bson/stm32simh/pinmap.png

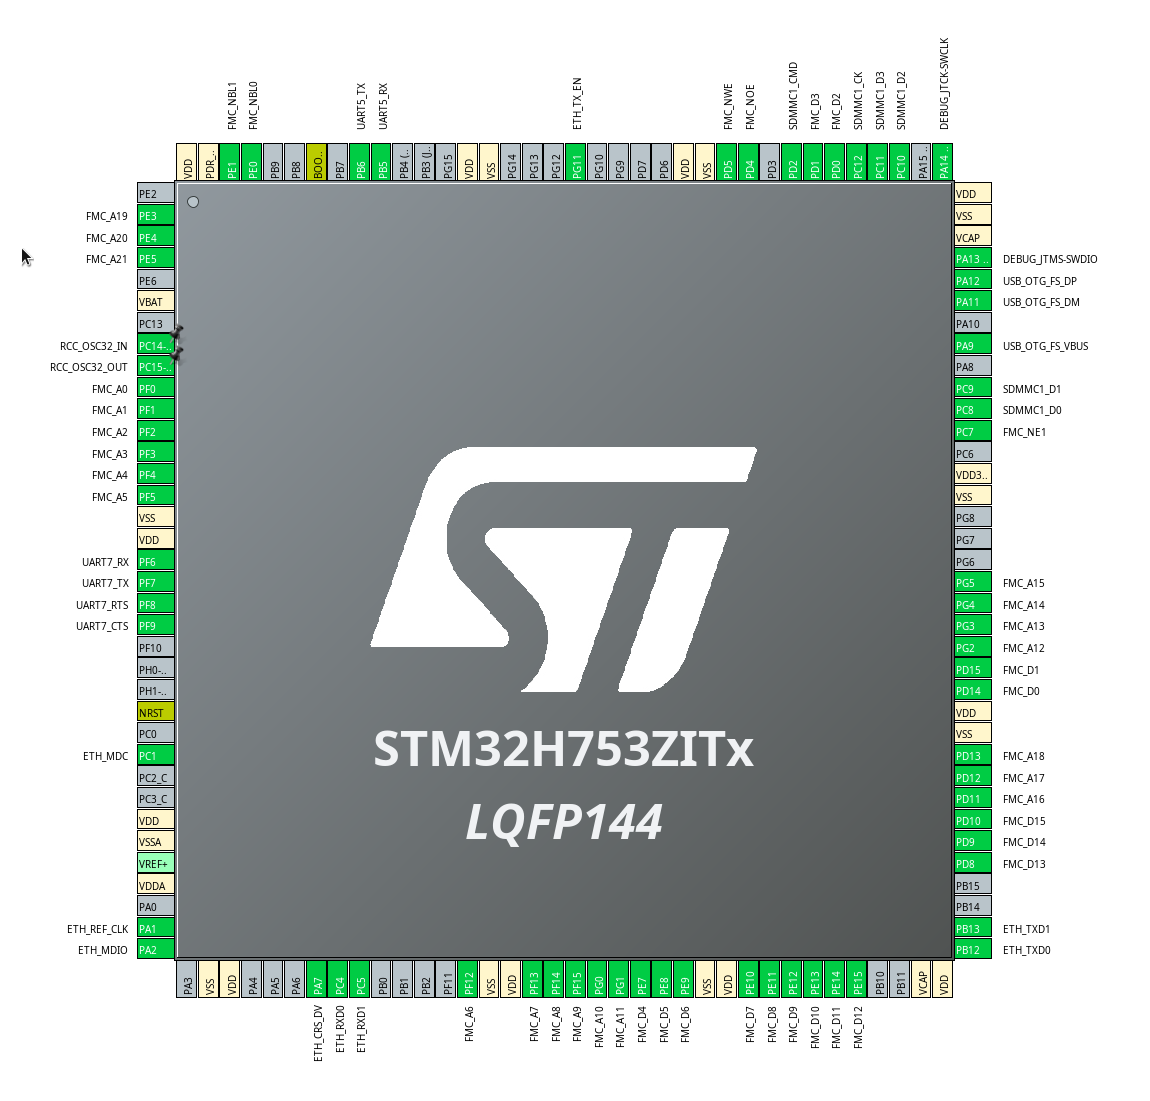
pinmap.png
