bson/stm32simh/stm32simh.kicad_pcb

## KiCad design stm32simh.kicad_pcb (2025-09-15)

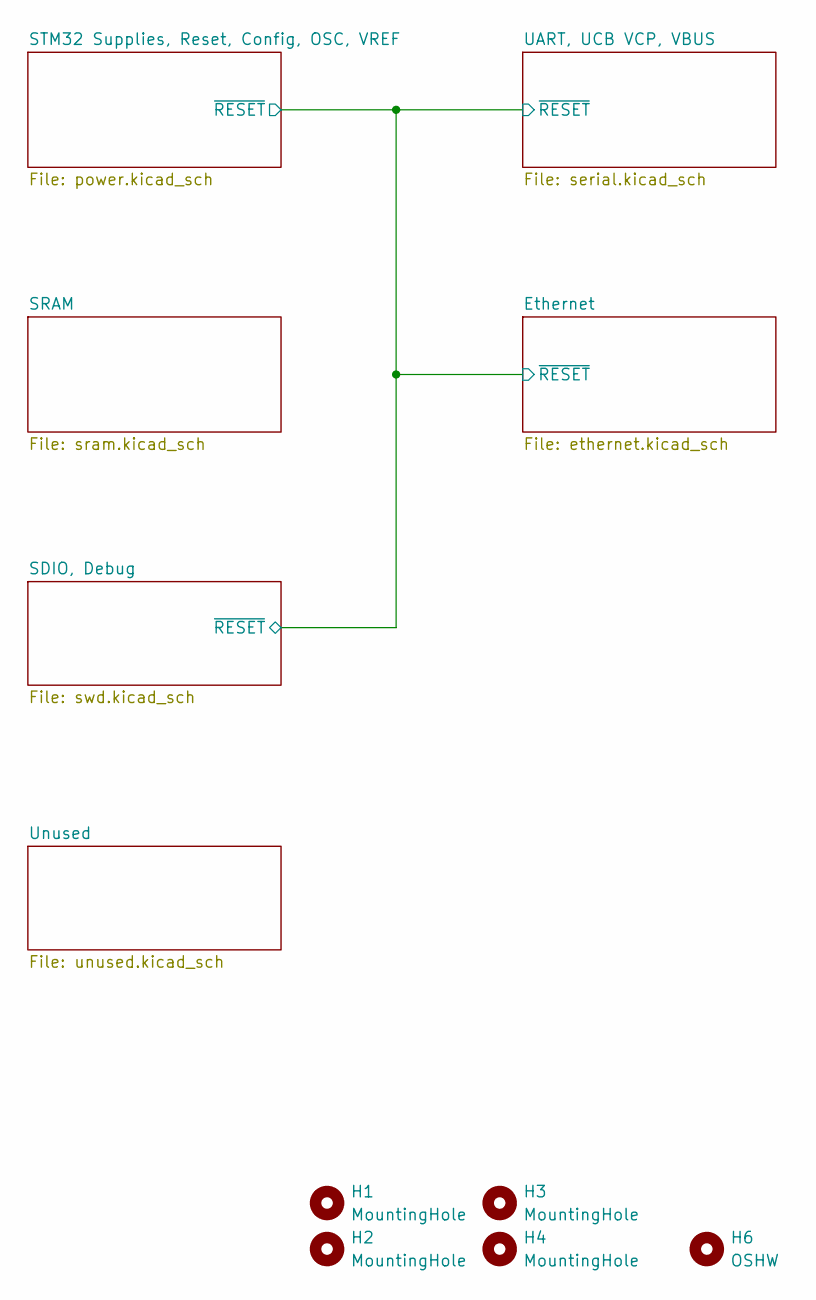
[picture p2: schematic stm32simh.kicad_sch]

Parts:
H1, H2, H3, H4: MountingHole; MountingHole_2.2mm_M2_ISO14580_Pad
H6: OSHW; OSHW-Logo_7.5x8mm_SilkScreen

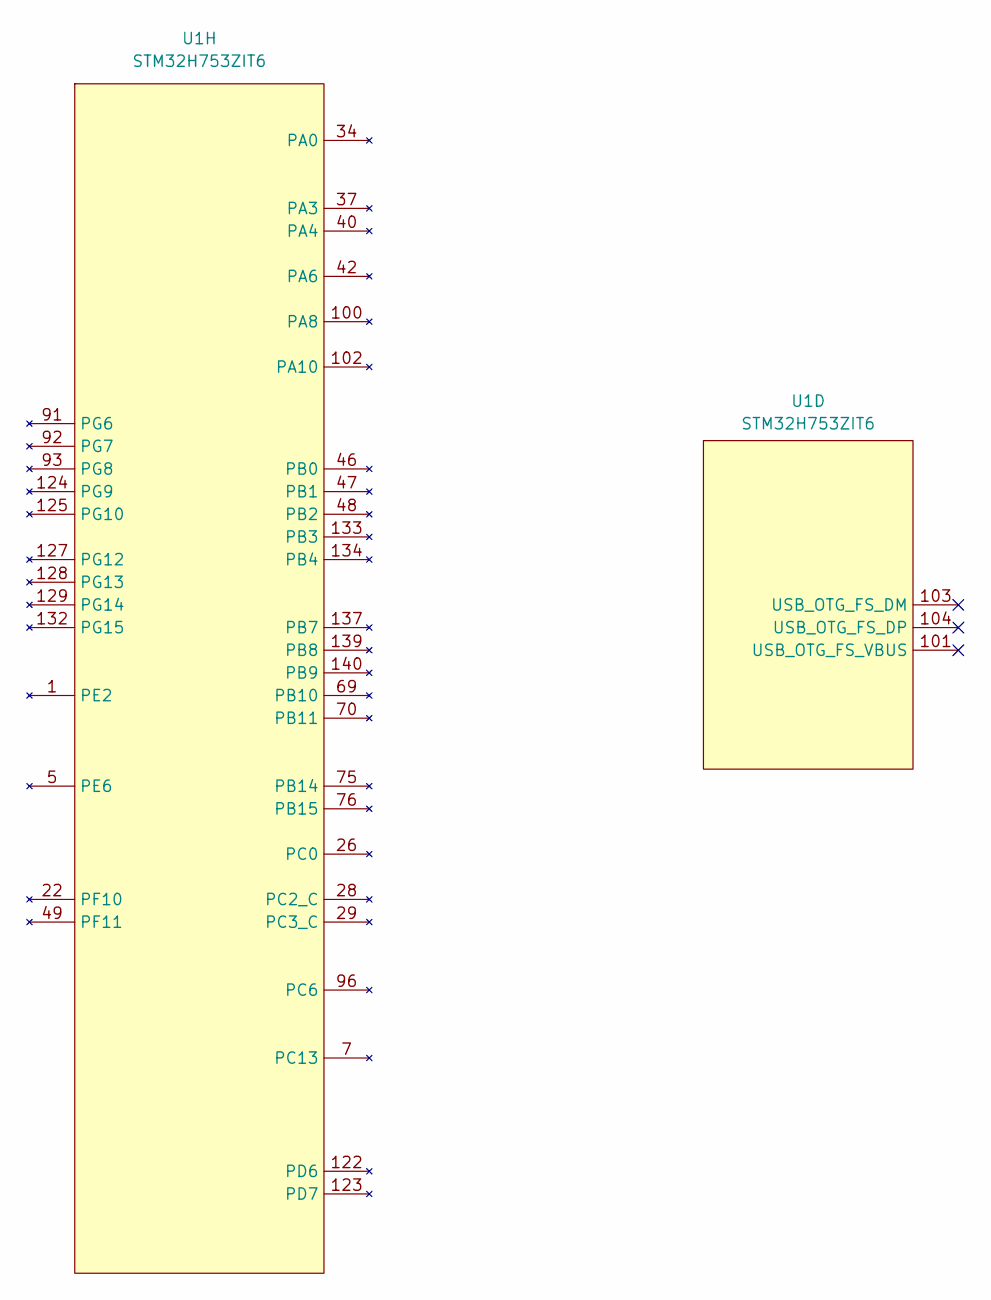
[picture p3: schematic unused.kicad_sch]

Parts:
U1: STM32H753ZIT6; LQFP-144_20x20mm_P0.5mm; MPN STM32H753ZIT6

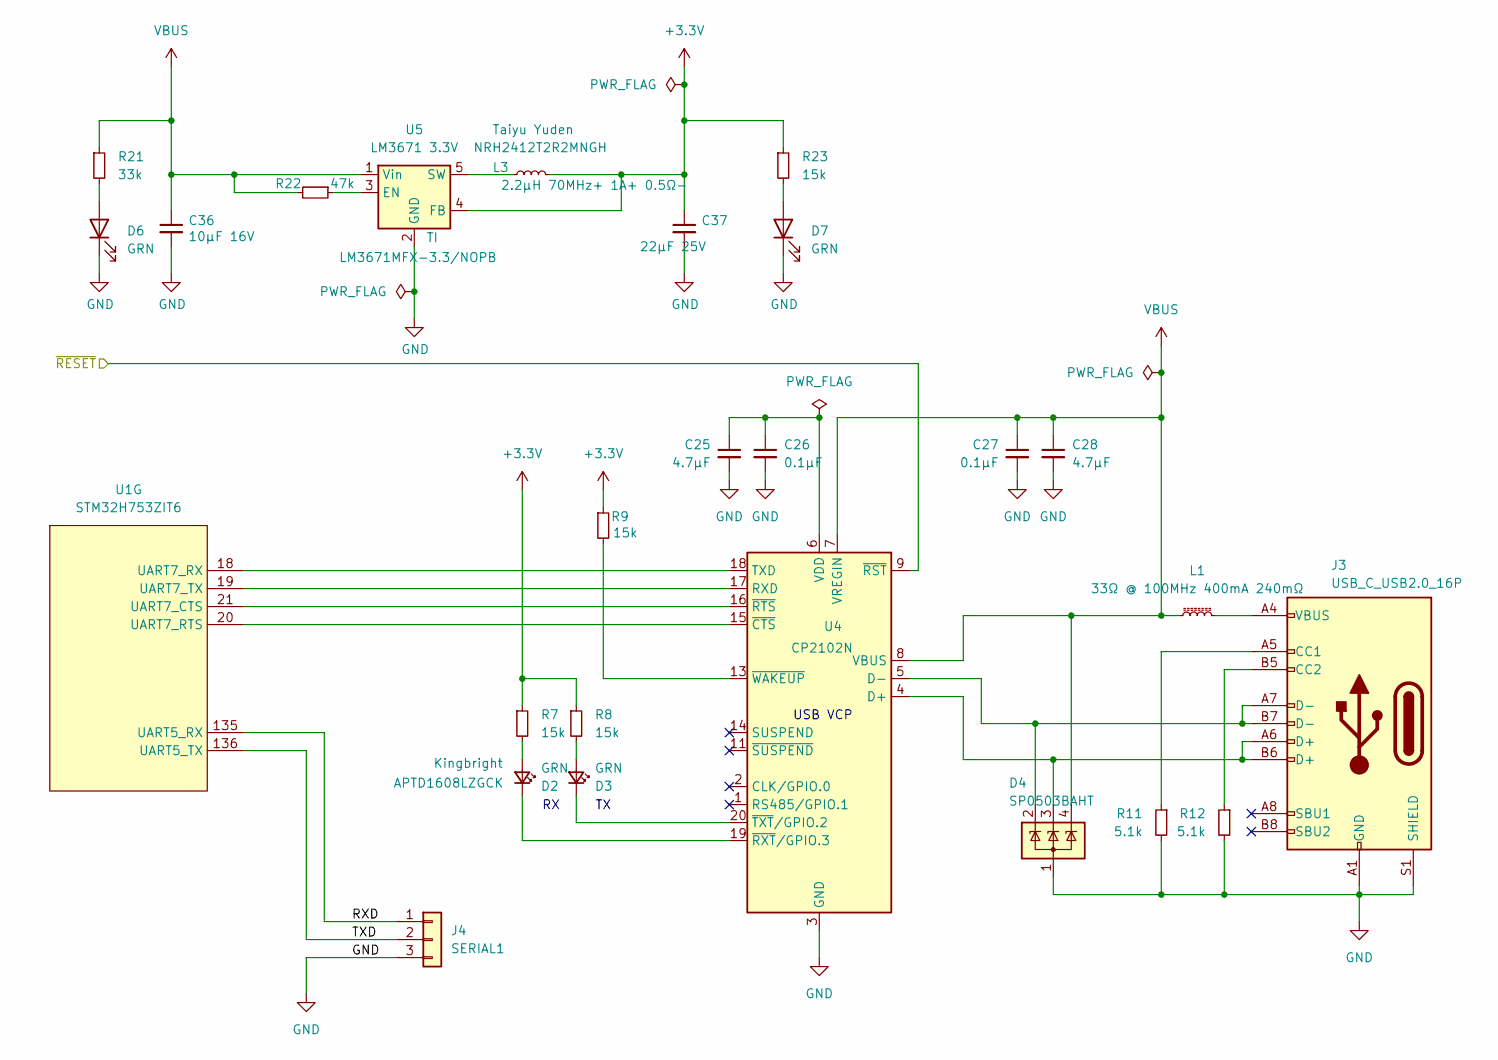
[picture p4: schematic serial.kicad_sch]

Parts:
C25, C28: 4.7µF; C_0805_2012Metric; LCSC C84718
C26, C27: 0.1µF; C_0402_1005Metric; LCSC C3012376
C36: 10µF 16V; C_0603_1608Metric; LCSC C109457
C37: 22µF 25V; C_0805_2012Metric; LCSC C258782
D2, D3: GRN; D_0603_1608Metric; MPN APTD1608LZGCK; LCSC C5246833
D4: SP0503BAHT; SOT-143; LCSC C5337181
D6, D7: GRN; D_0603_1608Metric; LCSC C5246833
J3: USB_C_USB2.0_16P; USB_C_Receptacle_HCTL_HC-TYPE-C-16P-01A; LCSC C2909599
J4: SERIAL1; PinHeader_1x03_P2.54mm_Vertical
L1: 33Ω @ 100MHz 400mA 240mΩ; L_0402_1005Metric; MPN MMZ1005D330CTD25
L3: 2.2µH 70MHz+ 1A+ 0.5Ω-; L_Taiyo-Yuden_NR-24xx; Part NRH2412T2R2MNGH
R7, R8, R23: 15k; R_0402_1005Metric; LCSC C850820
R9: 15k; R_0402_1005Metric; LCSC C375970
R11, R12: 5.1k; R_0402_1005Metric; LCSC C384321
R21: 33k; R_0402_1005Metric; LCSC C2906928
R22: 47k; R_0402_1005Metric; LCSC C3017507
U1: STM32H753ZIT6; LQFP-144_20x20mm_P0.5mm; MPN STM32H753ZIT6
U4: CP2102N; CP2102N-QFN20; LCSC C969913
U5: LM3671 3.3V; TSOT-23-5; Part LM3671MFX-3.3/NOPB; LCSC C201586

Connections:
+3.3V: C37.1, L3.2, R7.1, R8.1, R9.1, R23.1, U5.4 (FB); also elsewhere on the board
/Ethernet/~RESET: U4.9 (~RST); also elsewhere on the board
/UART, UCB VCP, VBUS/RXD: J4.1, U1.135 (UART5_RX)
/UART, UCB VCP, VBUS/TXD: J4.2, U1.136 (UART5_TX)
GND: C25.2, C26.2, C27.2, C28.2, C36.2, C37.2, D4.1 (A), D6.1 (K), D7.1 (K), J3.A1 (GND), J3.A12 (GND), J3.B1 (GND), J3.B12 (GND), J3.S1 (SHIELD), J4.3, R11.2, R12.2, U4.3 (GND), U4.12 (GND), U4.21 (GND), U5.2 (GND); also elsewhere on the board
unnamed: D2.2 (A), R7.2
unnamed: D2.1 (K), U4.19 (~RXT/GPIO.3)
unnamed: D3.2 (A), R8.2
unnamed: D3.1 (K), U4.20 (~TXT/GPIO.2)
unnamed: D6.2 (A), R21.2
unnamed: D7.2 (A), R23.2
unnamed: J3.A5 (CC1), R11.1
unnamed: J3.B5 (CC2), R12.1
unnamed: J3.A4 (VBUS), J3.A9 (VBUS), J3.B4 (VBUS), J3.B9 (VBUS), L1.2
unnamed: U1.21 (UART7_CTS), U4.16 (~RTS)
unnamed: U1.20 (UART7_RTS), U4.15 (~CTS)
unnamed: U1.18 (UART7_RX), U4.18 (TXD)
unnamed: U1.19 (UART7_TX), U4.17 (RXD)
unnamed: D4.3 (K), J3.A6 (D+), J3.B6 (D+), U4.4 (D+)
unnamed: D4.2 (K), J3.A7 (D-), J3.B7 (D-), U4.5 (D-)
unnamed: C25.1, C26.1, U4.6 (VDD)
unnamed: R9.2, U4.13 (~WAKEUP)
unnamed: R22.1, U5.3 (EN)
unnamed: L3.1, U5.5 (SW)
VBUS: C27.1, C28.1, C36.1, D4.4 (K), L1.1, R21.1, R22.2, U4.7 (VREGIN), U4.8 (VBUS), U5.1 (Vin)

Notes on the sheet:
USB VCP

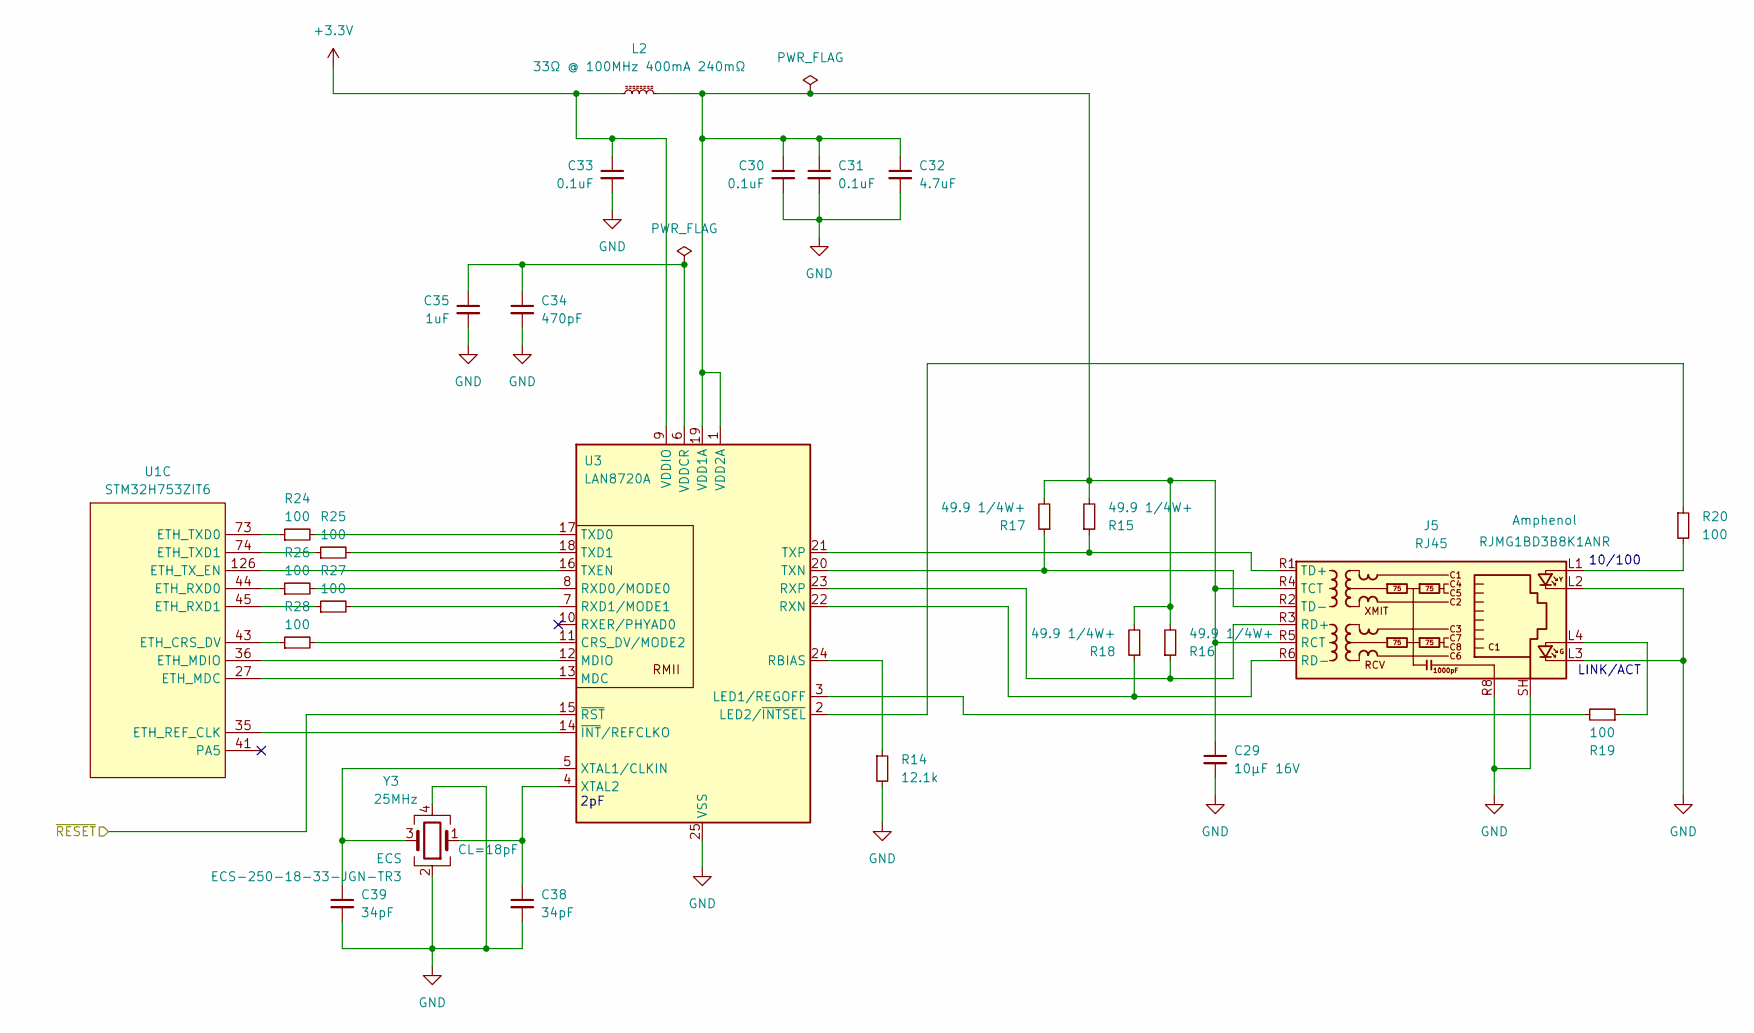
[picture p5: schematic ethernet.kicad_sch]

Parts:
C29: 10µF 16V; C_0603_1608Metric; LCSC C109457
C30, C31, C33: 0.1uF; C_0402_1005Metric
C32: 4.7uF; C_0805_2012Metric
C34: 470pF; C_0402_1005Metric
C35: 1uF; C_0402_1005Metric
C38, C39: 34pF; C_0402_1005Metric
J5: RJ45; RJ45_Amphenol_RJMG1BD3B8K1ANR; Part RJMG1BD3B8K1ANR
L2: 33Ω @ 100MHz 400mA 240mΩ; L_0402_1005Metric; MPN MMZ1005D330CTD25
R14: 12.1k; R_0402_1005Metric
R15, R16, R17, R18: 49.9 1/4W+; R_0805_2012Metric; LCSC C4088942
R19, R20, R24, R25, R26, R27, R28: 100; R_0402_1005Metric; LCSC C453594
U1: STM32H753ZIT6; LQFP-144_20x20mm_P0.5mm; MPN STM32H753ZIT6
U3: LAN8720A; VQFN-24-1EP_4x4mm_P0.5mm_EP2.5x2.5mm
Y3: 25MHz; Crystal_SMD_3225-4Pin_3.2x2.5mm; Part ECS-250-18-33-JGN-TR3; LCSC C7294571

Connections:
+3.3V: C33.1, L2.1, U3.9 (VDDIO); also elsewhere on the board
/Ethernet/~RESET: U3.15 (~RST); also elsewhere on the board
GND: C29.2, C30.2, C31.2, C32.2, C33.2, C34.2, C35.2, C38.2, C39.2, J5.L2, J5.L3, J5.R8, J5.SH, R14.2, U3.25 (VSS), Y3.2, Y3.4; also elsewhere on the board
unnamed: J5.L1, R20.2
unnamed: J5.L4, R19.1
unnamed: C29.1, C30.1, C31.1, C32.1, J5.R4 (TCT), J5.R5 (RCT), L2.2, R15.2, R16.2, R17.2, R18.2, U3.1 (VDD2A), U3.19 (VDD1A)
unnamed: J5.R3 (RD+), R16.1, U3.23 (RXP)
unnamed: J5.R6 (RD-), R18.1, U3.22 (RXN)
unnamed: J5.R1 (TD+), R15.1, U3.21 (TXP)
unnamed: J5.R2 (TD-), R17.1, U3.20 (TXN)
unnamed: R28.1, U1.43 (ETH_CRS_DV)
unnamed: U1.27 (ETH_MDC), U3.13 (MDC)
unnamed: U1.36 (ETH_MDIO), U3.12 (MDIO)
unnamed: U1.35 (ETH_REF_CLK), U3.14 (~INT/REFCLKO)
unnamed: R26.1, U1.44 (ETH_RXD0)
unnamed: R27.1, U1.45 (ETH_RXD1)
unnamed: R24.1, U1.73 (ETH_TXD0)
unnamed: R25.1, U1.74 (ETH_TXD1)
unnamed: U1.126 (ETH_TX_EN), U3.16 (TXEN)
unnamed: R28.2, U3.11 (CRS_DV/MODE2)
unnamed: R19.2, U3.3 (LED1/REGOFF)
unnamed: R20.1, U3.2 (LED2/~INTSEL)
unnamed: R14.1, U3.24 (RBIAS)
unnamed: R26.2, U3.8 (RXD0/MODE0)
unnamed: R27.2, U3.7 (RXD1/MODE1)
unnamed: R24.2, U3.17 (TXD0)
unnamed: R25.2, U3.18 (TXD1)
unnamed: C34.1, C35.1, U3.6 (VDDCR)
unnamed: C39.1, U3.5 (XTAL1/CLKIN), Y3.3
unnamed: C38.1, U3.4 (XTAL2), Y3.1

Notes on the sheet:
LINK/ACT
2pF
10/100

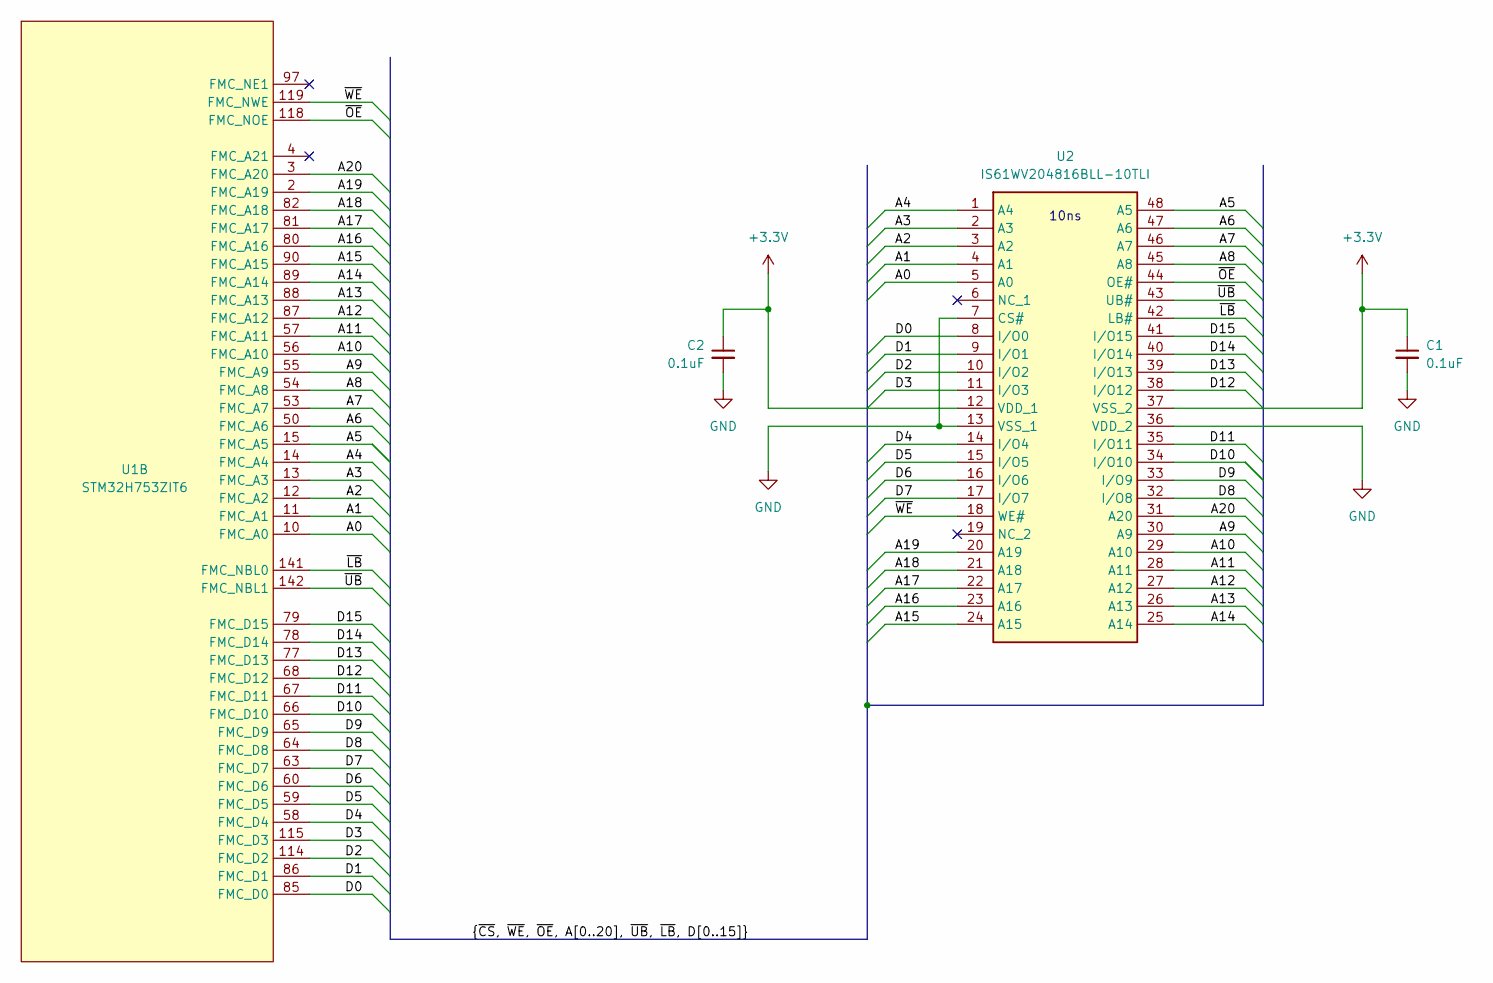
[picture p6: schematic sram.kicad_sch]

Parts:
C1, C2: 0.1uF; C_0402_1005Metric
U1: STM32H753ZIT6; LQFP-144_20x20mm_P0.5mm; MPN STM32H753ZIT6
U2: IS61WV204816BLL-10TLI; SOP50P2000X120-48N; Mouser Part Number 870-WV204816BLL10TLI

Connections:
+3.3V: C1.1, C2.1, U2.12 (VDD_1), U2.37 (VSS_2); also elsewhere on the board
/SRAM/A0: U1.10 (FMC_A0), U2.5 (A0)
/SRAM/A1: U1.11 (FMC_A1), U2.4 (A1)
/SRAM/A2: U1.12 (FMC_A2), U2.3 (A2)
/SRAM/A3: U1.13 (FMC_A3), U2.2 (A3)
/SRAM/A4: U1.14 (FMC_A4), U2.1 (A4)
/SRAM/A5: U1.15 (FMC_A5), U2.48 (A5)
/SRAM/A6: U1.50 (FMC_A6), U2.47 (A6)
/SRAM/A7: U1.53 (FMC_A7), U2.46 (A7)
/SRAM/A8: U1.54 (FMC_A8), U2.45 (A8)
/SRAM/A9: U1.55 (FMC_A9), U2.30 (A9)
/SRAM/A10: U1.56 (FMC_A10), U2.29 (A10)
/SRAM/A11: U1.57 (FMC_A11), U2.28 (A11)
/SRAM/A12: U1.87 (FMC_A12), U2.27 (A12)
/SRAM/A13: U1.88 (FMC_A13), U2.26 (A13)
/SRAM/A14: U1.89 (FMC_A14), U2.25 (A14)
/SRAM/A15: U1.90 (FMC_A15), U2.24 (A15)
/SRAM/A16: U1.80 (FMC_A16), U2.23 (A16)
/SRAM/A17: U1.81 (FMC_A17), U2.22 (A17)
/SRAM/A18: U1.82 (FMC_A18), U2.21 (A18)
/SRAM/A19: U1.2 (FMC_A19), U2.20 (A19)
/SRAM/A20: U1.3 (FMC_A20), U2.31 (A20)
/SRAM/D0: U1.85 (FMC_D0), U2.8 (I/O0)
/SRAM/D1: U1.86 (FMC_D1), U2.9 (I/O1)
/SRAM/D2: U1.114 (FMC_D2), U2.10 (I/O2)
/SRAM/D3: U1.115 (FMC_D3), U2.11 (I/O3)
/SRAM/D4: U1.58 (FMC_D4), U2.14 (I/O4)
/SRAM/D5: U1.59 (FMC_D5), U2.15 (I/O5)
/SRAM/D6: U1.60 (FMC_D6), U2.16 (I/O6)
/SRAM/D7: U1.63 (FMC_D7), U2.17 (I/O7)
/SRAM/D8: U1.64 (FMC_D8), U2.32 (I/O8)
/SRAM/D9: U1.65 (FMC_D9), U2.33 (I/O9)
/SRAM/D10: U1.66 (FMC_D10), U2.34 (I/O10)
/SRAM/D11: U1.67 (FMC_D11), U2.35 (I/O11)
/SRAM/D12: U1.68 (FMC_D12), U2.38 (I/O12)
/SRAM/D13: U1.77 (FMC_D13), U2.39 (I/O13)
/SRAM/D14: U1.78 (FMC_D14), U2.40 (I/O14)
/SRAM/D15: U1.79 (FMC_D15), U2.41 (I/O15)
/SRAM/~LB: U1.141 (FMC_NBL0), U2.42 (LB#)
/SRAM/~OE: U1.118 (FMC_NOE), U2.44 (OE#)
/SRAM/~UB: U1.142 (FMC_NBL1), U2.43 (UB#)
/SRAM/~WE: U1.119 (FMC_NWE), U2.18 (WE#)
GND: C1.2, C2.2, U2.7 (CS#), U2.13 (VSS_1), U2.36 (VDD_2); also elsewhere on the board

Notes on the sheet:
10ns

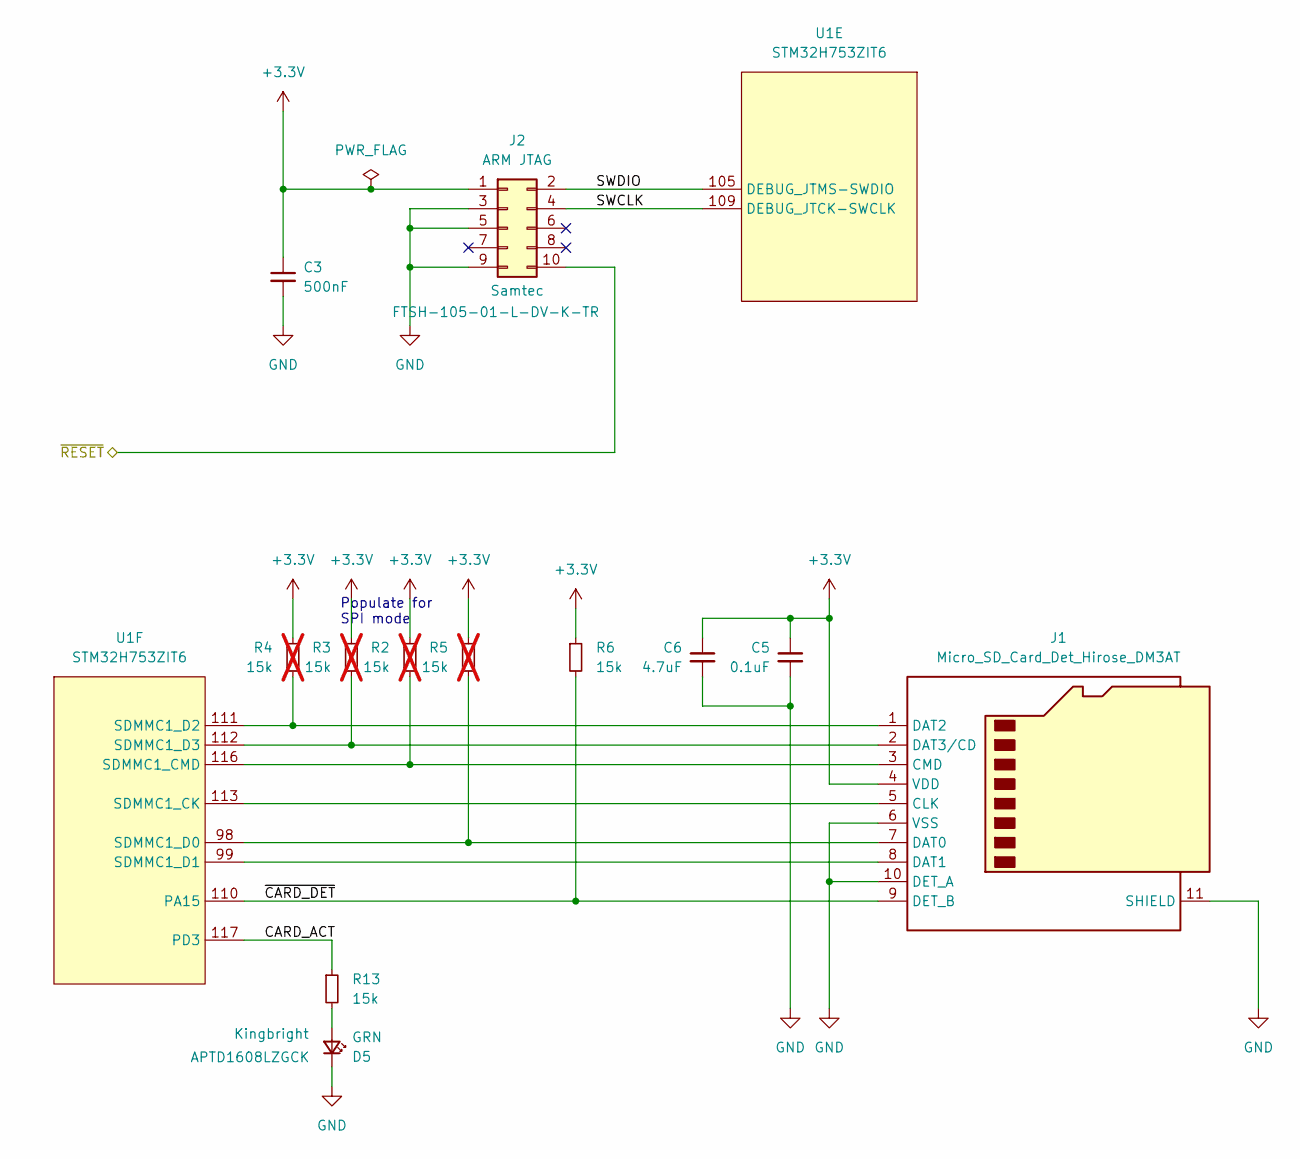
[picture p7: schematic swd.kicad_sch]

Parts:
C3: 500nF; C_0402_1005Metric
C5: 0.1uF; C_0402_1005Metric
C6: 4.7uF; C_0805_2012Metric
D5: GRN; D_0603_1608Metric; MPN APTD1608LZGCK; LCSC C5246833
J1: Micro_SD_Card_Det_Hirose_DM3AT; microSD_HC_Hirose_DM3AT-SF-PEJM5
J2: ARM JTAG; SOIC-10_3.9x4.9mm_P1mm; MPN FTSH-105-01-L-DV-K-TR
R2, R3, R4, R5: 15k; R_0402_1005Metric; not fitted
R6: 15k; R_0402_1005Metric
R13: 15k; R_0402_1005Metric; LCSC C850820
U1: STM32H753ZIT6; LQFP-144_20x20mm_P0.5mm; MPN STM32H753ZIT6

Connections:
+3.3V: C3.1, C5.1, C6.1, J1.4 (VDD), J2.1, R2.1, R3.1, R4.1, R5.1, R6.1; also elsewhere on the board
/Ethernet/~RESET: J2.10; also elsewhere on the board
/SDIO, Debug/CARD_ACT: R13.1, U1.117 (PD3)
/SDIO, Debug/SWCLK: J2.4, U1.109 (DEBUG_JTCK-SWCLK)
/SDIO, Debug/SWDIO: J2.2, U1.105 (DEBUG_JTMS-SWDIO)
/SDIO, Debug/~CARD_DET: J1.9 (DET_B), R6.2, U1.110 (PA15)
GND: C3.2, C5.2, C6.2, D5.1 (K), J1.6 (VSS), J1.10 (DET_A), J1.11 (SHIELD), J2.3, J2.5, J2.9; also elsewhere on the board
unnamed: D5.2 (A), R13.2
unnamed: J1.5 (CLK), U1.113 (SDMMC1_CK)
unnamed: J1.3 (CMD), R2.2, U1.116 (SDMMC1_CMD)
unnamed: J1.7 (DAT0), R5.2, U1.98 (SDMMC1_D0)
unnamed: J1.8 (DAT1), U1.99 (SDMMC1_D1)
unnamed: J1.1 (DAT2), R4.2, U1.111 (SDMMC1_D2)
unnamed: J1.2 (DAT3/CD), R3.2, U1.112 (SDMMC1_D3)

Notes on the sheet:
Populate for SPI mode

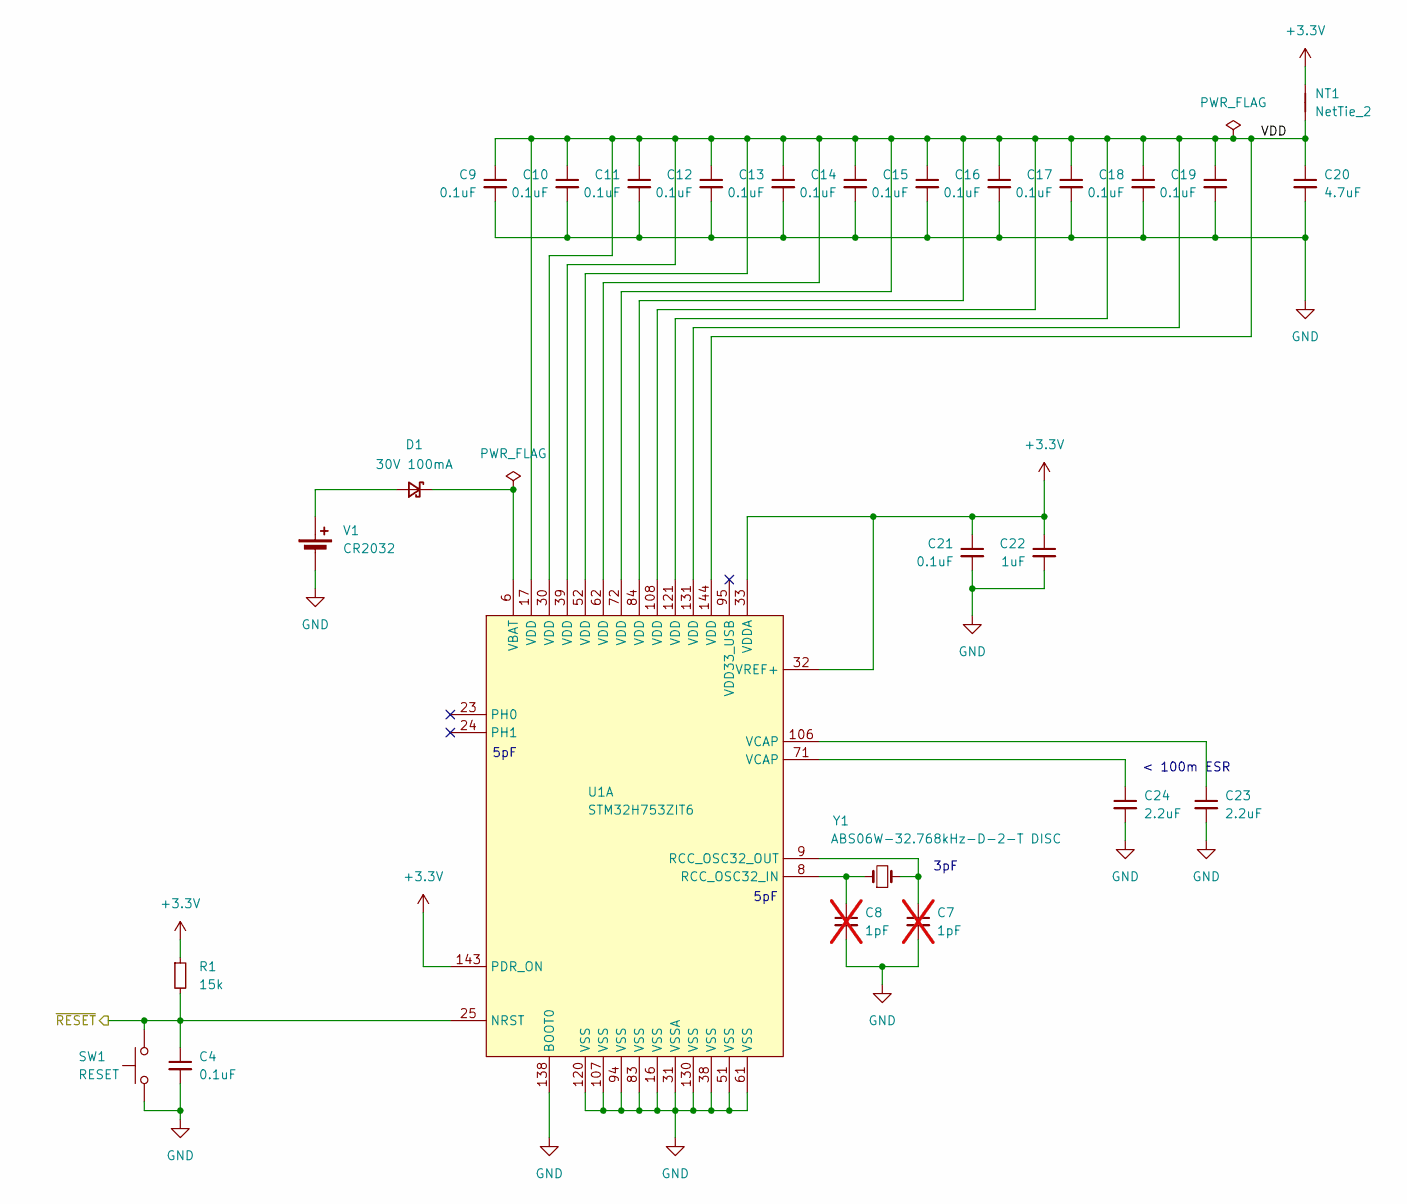
[picture p8: schematic power.kicad_sch]

Parts:
C4, C9, C10, C11, C12, C13, C14, C15, C16, C17, C18, C19, C21: 0.1uF; C_0402_1005Metric
C7, C8: 1pF; C_0402_1005Metric; not fitted
C20: 4.7uF; C_0805_2012Metric
C22: 1uF; C_0402_1005Metric
C23, C24: 2.2uF; C_0603_1608Metric
D1: 30V 100mA; D_0603_1608Metric; MPN CDBU0130L-HF
NT1: NetTie_2; NetTie-2_SMD_Pad0.5mm
R1: 15k; R_0402_1005Metric
SW1: RESET; SW_SPST_CK_RS282G05A3
U1: STM32H753ZIT6; LQFP-144_20x20mm_P0.5mm; MPN STM32H753ZIT6
V1: CR2032; BatteryHolder_Keystone_1060_1x2032; MPN 1060TR
Y1: ABS06W-32.768kHz-D-2-T DISC; Crystal_SMD_2012-2Pin_2.0x1.2mm; MPN ABS06W-32.768KHZ-D-2-T

Connections:
+3.3V: C21.1, C22.1, NT1.2, R1.1, U1.32 (VREF+), U1.33 (VDDA), U1.143 (PDR_ON); also elsewhere on the board
/Ethernet/~RESET: C4.1, R1.2, SW1.1, U1.25 (NRST); also elsewhere on the board
/STM32 Supplies, Reset, Config, OSC, VREF/VDD: C9.1, C10.1, C11.1, C12.1, C13.1, C14.1, C15.1, C16.1, C17.1, C18.1, C19.1, C20.1, NT1.1, U1.17 (VDD), U1.30 (VDD), U1.39 (VDD), U1.52 (VDD), U1.62 (VDD), U1.72 (VDD), U1.84 (VDD), U1.108 (VDD), U1.121 (VDD), U1.131 (VDD), U1.144 (VDD)
GND: C4.2, C7.2, C8.2, C9.2, C10.2, C11.2, C12.2, C13.2, C14.2, C15.2, C16.2, C17.2, C18.2, C19.2, C20.2, C21.2, C22.2, C23.2, C24.2, SW1.2, U1.16 (VSS), U1.31 (VSSA), U1.38 (VSS), U1.51 (VSS), U1.61 (VSS), U1.83 (VSS), U1.94 (VSS), U1.107 (VSS), U1.120 (VSS), U1.130 (VSS), U1.138 (BOOT0), V1.2 (-); also elsewhere on the board
unnamed: C23.1, U1.106 (VCAP)
unnamed: C24.1, U1.71 (VCAP)
unnamed: D1.2 (A), V1.1 (+)
unnamed: D1.1 (K), U1.6 (VBAT)
unnamed: C8.1, U1.8 (RCC_OSC32_IN), Y1.1
unnamed: C7.1, U1.9 (RCC_OSC32_OUT), Y1.2

Notes on the sheet:
5pF
3pF
< 100m ESR

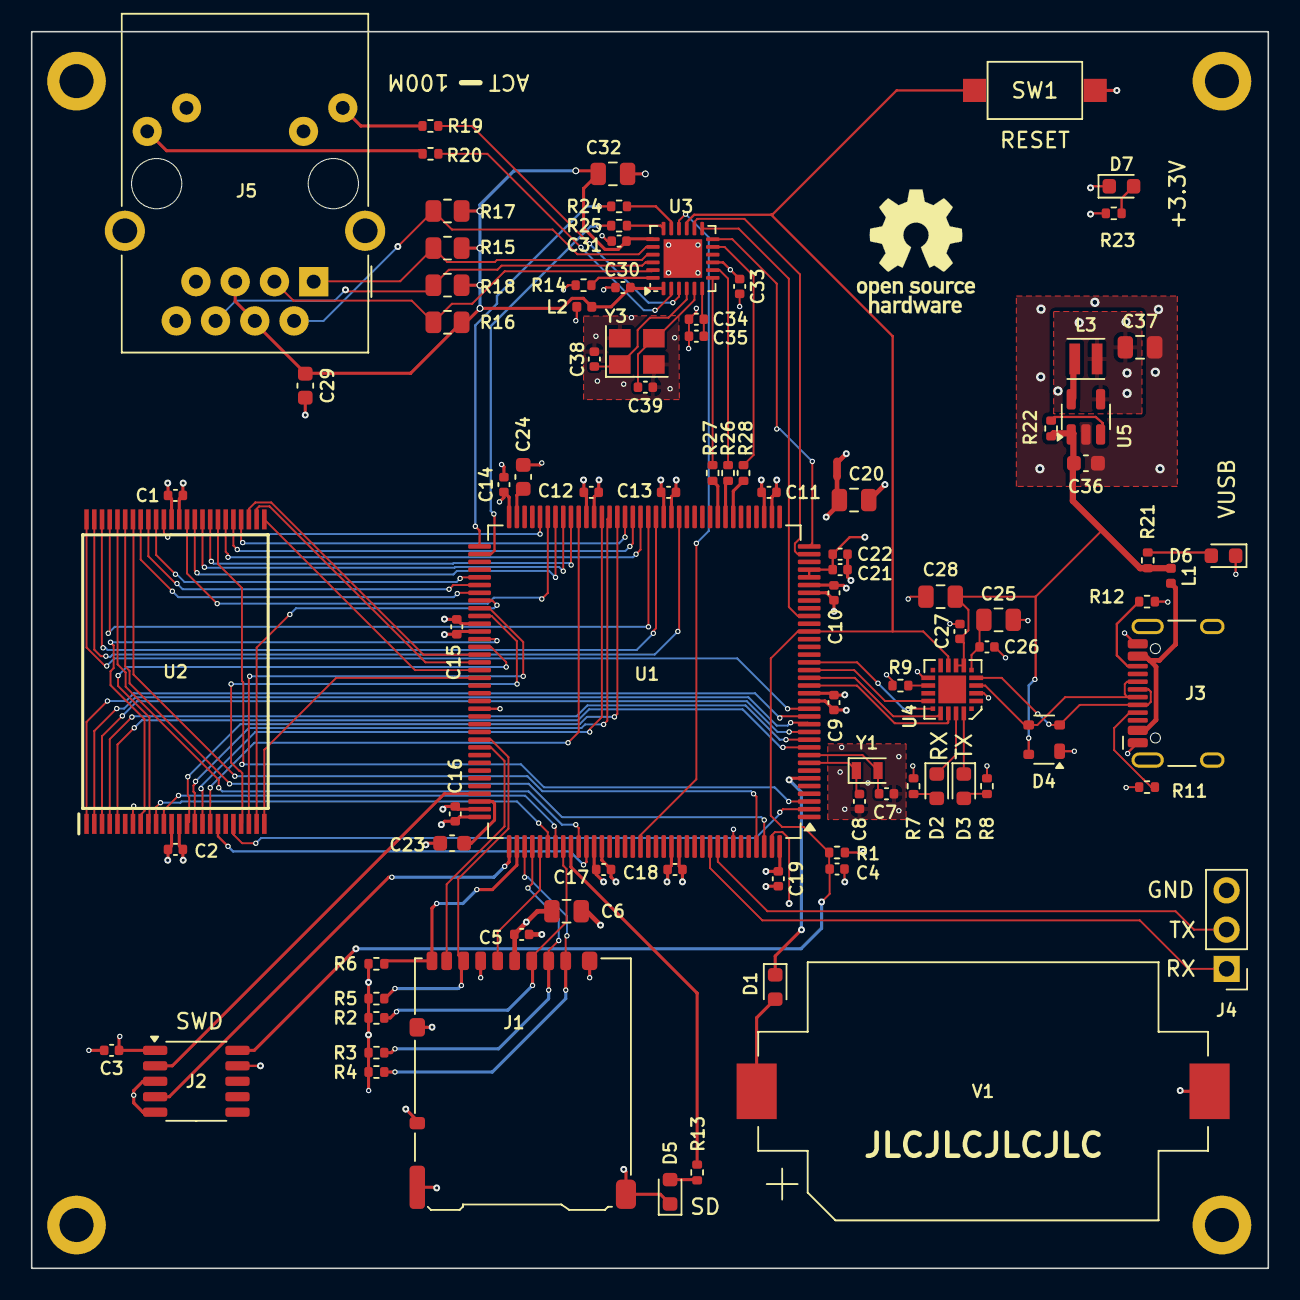
[picture p9: board stm32simh.kicad_pcb from above]

Board: 4 copper layers, 80.0 x 80.0 mm, 96 parts (0 on the bottom side), 111 nets.
