bson/stm32simh/(commit log)

2024-10-08 add a bunch of files
    [power.kicad_sch, sram.kicad_sch, stm32simh.kicad_pcb, stm32simh.kicad_sch, swd.kicad_sch]
2024-10-08 add SDIO
    [power.kicad_sch, sram.kicad_sch, stm32simh.kicad_sch, swd.kicad_sch, unused.kicad_sch]
2024-10-08 first stab at board layout
    [serial.kicad_sch, stm32simh.kicad_pcb, stm32simh.kicad_sch]
2024-10-08 VDD zone
    [power.kicad_sch, serial.kicad_sch, stm32simh.kicad_pcb]
2024-10-08 add reset button
    [power.kicad_sch, stm32simh.kicad_pcb]
2024-10-08 align holes
    [stm32simh.kicad_pcb]
2024-10-08 remove unused footprint
2024-10-09 add rev1 gerbers
    [stm32simh-B_Cu.gbl, stm32simh-B_Mask.gbs, stm32simh-B_Paste.gbp, stm32simh-B_Silkscreen.gbo, stm32simh-Edge_Cuts.gm1, stm32simh-F_Cu.gtl, stm32simh-F_Mask.gts, stm32simh-F_Paste.gtp]
2025-09-15 update to KiCad 9, add ibom
    [ethernet.kicad_sch, power.kicad_sch, serial.kicad_sch, sram.kicad_sch, stm32simh.kicad_pcb, stm32simh.kicad_sch, swd.kicad_sch, unused.kicad_sch]
2025-11-22 update for kicad 9.0.6
    [ethernet.kicad_sch, power.kicad_sch, serial.kicad_sch, sram.kicad_sch, stm32simh.kicad_sch, swd.kicad_sch, unused.kicad_sch]
